listirbg/rc_car/Controller/PCB/PCB_PCB_Controller-RC-Car_2024-11-23.png

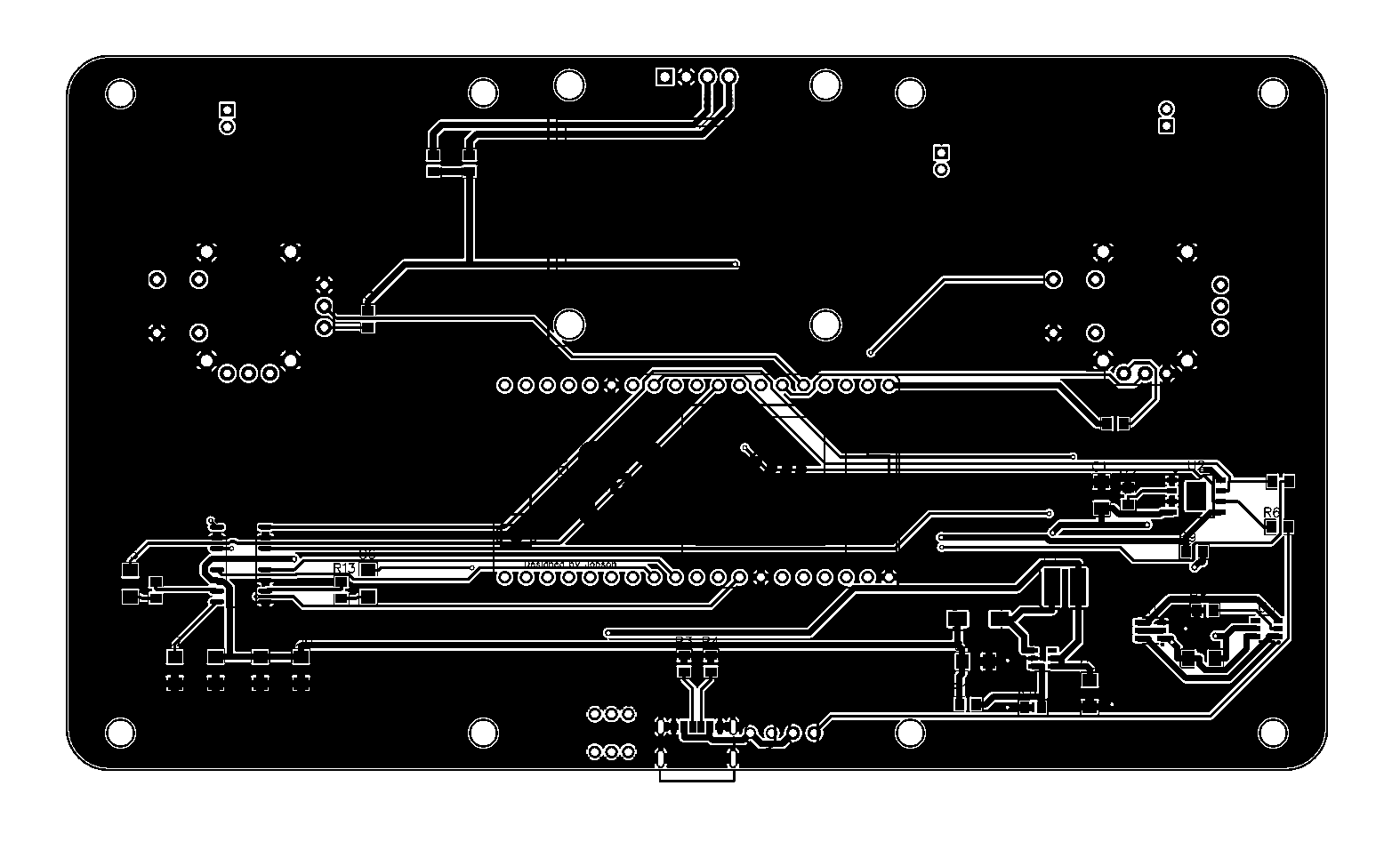
Controller/PCB/PCB_PCB_Controller-RC-Car_2024-11-23.png
