listirbg/rc_car/Kosten.xlsx

Bezeichnung | Menge | Preis | benötigt | Kosten | Kostenträger
ESP32 | 3 | 17.99 € | 2 | 11.99 € | Marcel List
Vorderachse | 1 | 25.39 € | 1 | 25.39 € | Timo Weber
Hinterachse | 1 | 20.19 € | 1 | 20.19 € | Timo Weber
Räder Set | 1 | 14.39 € | 1 | 14.39 € | Marcel List
Servomotor | 1 | 9.99 € | 1 | 9.99 € | Marcel List
Joystick | 4 | 9.99 € | 2 | 5.00 € | Marcel List
Akku Lipo 600mAh | 3 | 22.99 € | 1 | 7.66 € | Marcel List
OLED Displays 1,3" | 3 | 17.09 € | 1 | 5.70 € | Marcel List
Akku Lipo 2200mAh mit Ladegerät | 1 | 26.99 € | 1 | 26.99 € | Marcel List
Motor (mit ESC) | 1 | 31.28 € | 1 | 31.28 € | Marcel List
Lautsprecher | 4 | 8.09 € | 1 | 2.02 € | Marcel List
Platine Controller | 5 | 11.44 € | 1 | 2.29 € | Marcel List
Bauteile Controller | 5 | 22.36 € | 1 | 4.47 € | Marcel List
3D-Druck Filament pauschal | 1 | 20.00 € | 1 | 20.00 € | Marcel List
sonstige Verbrauchsmaterialien pauschal | 1 | 5.00 € | 1 | 5.00 € | alle
Gesamtkosten |  | 263.18 € |  | 192.36 €
