listirbg/rc_car/Auto/Bodenplatte v1.dxf

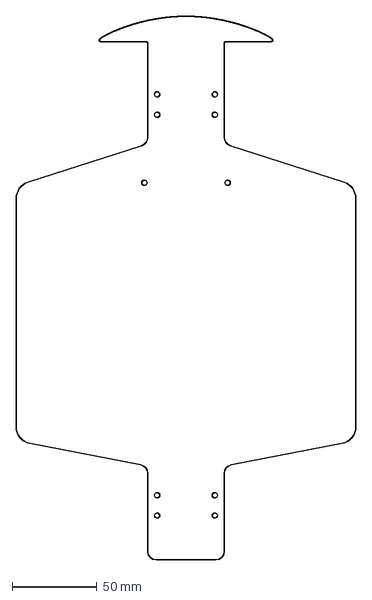
[picture p2: CAD file, 2024-12-01]
Auto/Bodenplatte v1.dxf
200.0 x 320.0 mm
