listirbg/rc_car/Controller/PCB/PCB_Controller-RC-Car_2024-11-23.dxf

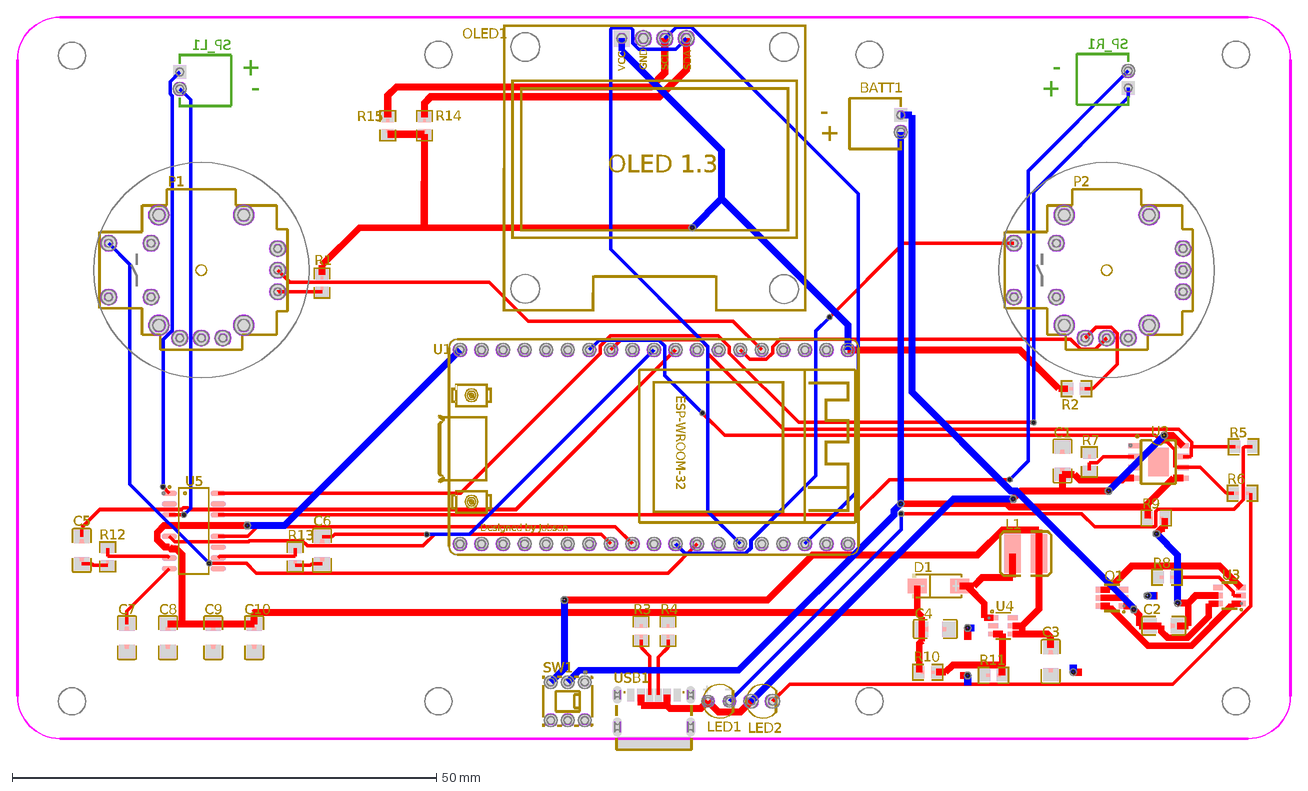
[picture p3: CAD file, 2024-12-01]
Controller/PCB/PCB_Controller-RC-Car_2024-11-23.dxf
+
-
SP_L1
SP_R1
R14
R15
C1
C2
C3
C4
D1
L1
LED1
LED2
P1
P2
Q1
U3
R1
R2
R3
R4
R5
R6
R7
R8
R9
R10
R11
SW1
U2
U4
USB1
BATT1
U1
ESP-WROOM-32
Designed by Jobson
OLED1
OLED 1.3
VCC
SCL
SDA
GND
C5
C6
C7
C8
C9
C10
R12
R13
U5
