listirbg/rc_car/(list of files, cad)

Other CAD files:
Auto/3D_Modelle/Abdeckung Welle v2.f3d
Auto/3D_Modelle/Bodenplatte v3.f3d
Auto/3D_Modelle/Halterung Akku v5.f3d
Auto/3D_Modelle/Halterung Platine v2.f3d
Auto/3D_Modelle/Halterung Servo-Motor v6.f3d
Auto/3D_Modelle/Heckspoiler v3.f3d
Auto/3D_Modelle/Lenkachse v1.f3d
Controller/3D_Modelle/Abdeckung LED v1.f3d
Controller/3D_Modelle/Button v8.f3d
Controller/3D_Modelle/Joystick v9.f3d
Controller/3D_Modelle/Joystickaufsatz v4.f3d
