listirbg/rc_car/Controller/Schaltplan/Schaltplan_Controller_RC-Car.pdf

# OLED1 SDA

## OLED

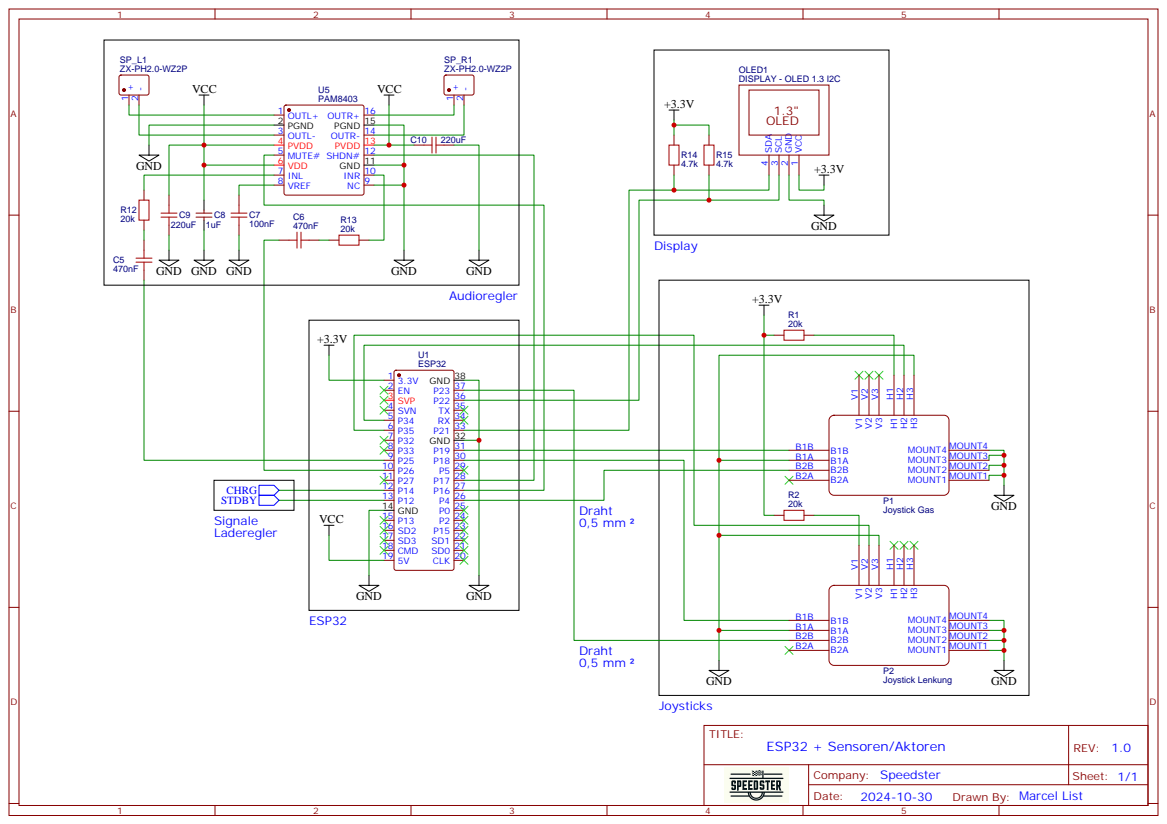
[picture p4: page 1]

PAM8403
INR 10 GND 11 SHDN# 12 PVDD 13 OUTR- 14 PGND 15 OUTR+ 16

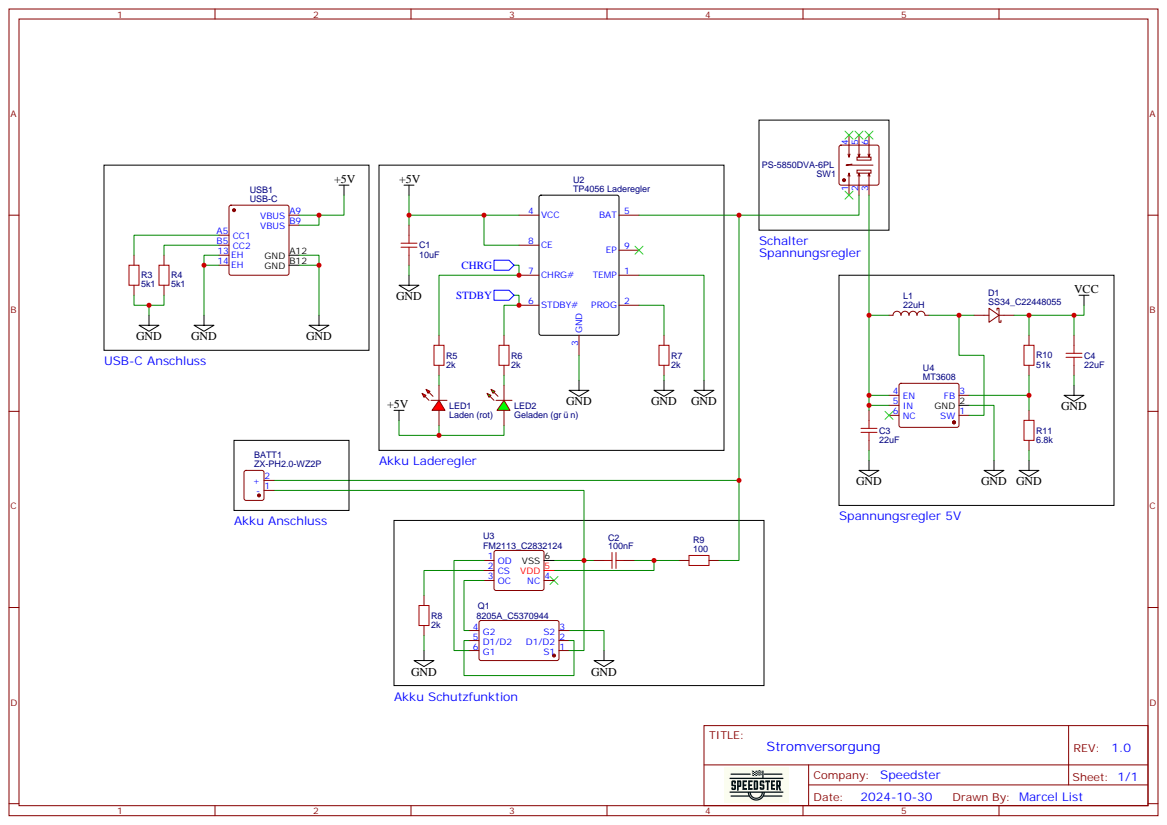
[picture p5: page 2]
