listirbg/rc_car/Auto/Schaltplan/Schaltplan_RC-Car.pdf

3S Lipo | +
12V

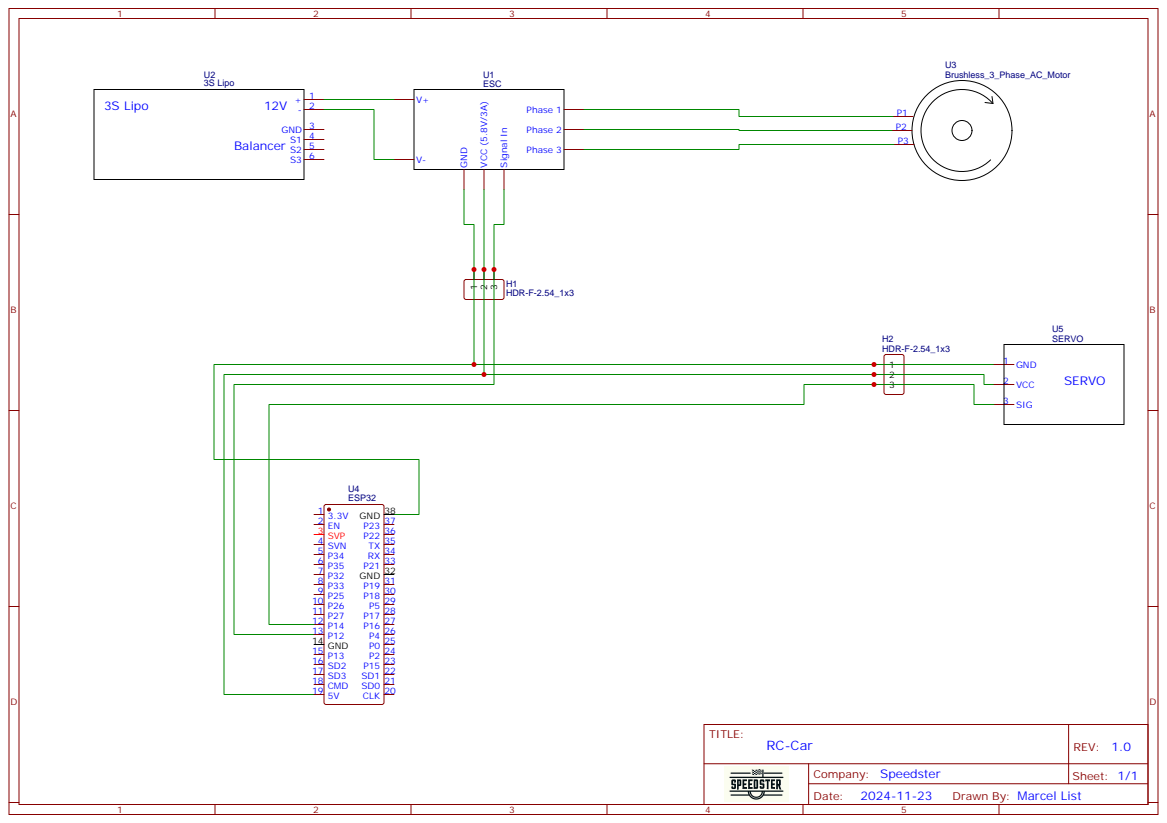
[picture p6: page 1]

Drawn By: Marcel List
