listirbg/rc_car/Software/Controller/main.py

# ######################
# Controller des RC-Cars
# ######################

# ### Modul-Imports
from machine import Pin, I2C, ADC, DAC, Timer
import sh1106
import pictures
import framebuf
import network
import espnow
import time


# ### Mac-Adressen
mac_controller = b'\x88\x13\xbfq\xc1\xcc'
mac_car = b'\xa0\xb7e-\xc4\xc4'


# ### ESP-NOW initialisieren

# WLAN aktivieren
network.phy_mode(network.MODE_11N)
sta = network.WLAN(network.STA_IF)
sta.active(True)
sta.config(pm=sta.PM_NONE)

# ESP-NOW initialisieren
en = espnow.ESPNow()
en.active(True)
en.config(timeout_ms=300)

# Empfänger hinzufügen
en.add_peer(mac_car)


# ### Funktionen definieren

# Logo auf dem Display anzeigen
def show_logo(display: sh1106.SH1106, duration_s: int = 0) -> None:
    # Logo als Byte-Array
    logo = pictures.logo()

    # FrameBuffer für das Logo erstellen
    fb = framebuf.FrameBuffer(logo, 128, 64, framebuf.MONO_VLSB)

    # Logo auf dem Display anzeigen
    display.fill(0)
    display.blit(fb, 0, 0)
    display.show()
    time.sleep(duration_s)


# Analogen Eingang einlesen, Wert stabilisieren und in 0 .. +- 100 % umwandeln
def read_input_calc(analog_input: ADC, last_val: int, hysteresis: int, invert: bool = False) -> int:
    # Wert am ADC einlesen
    val = analog_input.read_u16()
    # Wert ggf. invertieren
    if invert:
        val = -(val - 65535)
    # In Wert 0-65 umwandeln
    val = val // 1000

    # Neuen Wert in +- 100 % berechnen
    new_val = int(((val / 64) * 200) - 100)

    # Wert stabilisieren
    if (32 - hysteresis) < val < (32 + hysteresis):
        send_val = 0
    elif (new_val - last_val) < -hysteresis or (new_val - last_val) > hysteresis: # Berechnung passt nicht
        send_val = new_val
    else:
        send_val = last_val

    send_val = max(-100, min(100, send_val))
    return send_val


# Sound abspielen
def play_sound(output: DAC, output_mute: Pin, sound: str, sample_rate: int = 8000, chunk_size: int = 2048) -> None:
    output_mute.value(1)
    # Zeit zwischen Samples berechnen
    delay = int((1 / sample_rate)*1_000_000)
    with open(sound, "rb") as f:
        while True:
            chunk = f.read(chunk_size)
            if not chunk:
                break
            for sample in chunk:
                output.write(sample)
                time.sleep_us(delay)
    sound_mute.value(0)


# Auswertung Button
def button_check(button: Pin, last_state: bool) -> tuple[bool, bool]:
    state = True if not bool(button.value()) else False
    if state and state != last_state:
        return (True, state)
    else:
        return (False, state)


# ### Ein-/Ausgänge definieren

# Display SH1106 OLED (I2C)
i2c = I2C(0, scl=Pin(22), sda=Pin(21), freq=100000)
oled = sh1106.SH1106_I2C(128, 64, i2c, rotate=180)

# Steuerung
# Joystick Gas
joystick_throttle = ADC(34)
joystick_throttle_button = Pin(4, Pin.IN, Pin.PULL_UP)
joystick_angle = ADC(35)
joystick_angle_button = Pin(23, Pin.IN, Pin.PULL_UP)

# Audio-Verstärker
# sound_left_channel = DAC(25)  # nicht verwendet, da kein Lautsprecher angeschlossen
sound_right_channel = DAC(26)
sound_mute = Pin(16, Pin.OUT)
sound_shutdown = Pin(17, Pin.OUT, value=1)

# Laderegler
# charger_charging = Pin(14, Pin.IN, Pin.PULL_UP)  # Keine Verwendung
# charger_standby = Pin(12, Pin.IN, Pin.PULL_UP)  # Keine Verwendung


# ### Programmablauf

# Logo im Display anzeigen
show_logo(oled, 0)

# Sound abspielen
play_sound(sound_right_channel, sound_mute, "startup.raw")

# Null-Werte definieren
joystick_angle_button_flank = (False, False)
joystick_throttle_button_flank = (False, False)
speed_mode = 0
send_val_throttle = 32
send_val_angle = 32
connection = False
timer_connection = 0
first_cycle = True

# Geschwindigkeitsmodi
speed_modes = [0.1, 0.25, 0.5, 0.75, 1]


# ### Main-Loop
while True:
    try:
        # Buttons auswerten
        joystick_angle_button_flank = button_check(joystick_angle_button, joystick_angle_button_flank[1])
        joystick_throttle_button_flank = button_check(joystick_throttle_button, joystick_throttle_button_flank[1])

        # Fahrmodi umschalten
        if joystick_angle_button_flank[0] and speed_mode < len(speed_modes) - 1:
            speed_mode += 1
        elif joystick_angle_button_flank[0] and speed_mode == len(speed_modes) - 1:
            speed_mode = 0

        max_throttle = speed_modes[speed_mode]

        # Werte einlesen
        val_throttle = read_input_calc(joystick_throttle, send_val_throttle, 3, True)
        send_val_throttle = int(val_throttle * max_throttle)
        if 0 < send_val_throttle < 5:
            send_val_throttle = 5
        elif -5 < send_val_throttle < 0:
            send_val_throttle = -5

        send_val_angle = read_input_calc(joystick_angle, send_val_angle, 3, False)

        # Werte an RC-Car senden
        send_text = f"gas:{int(send_val_throttle)},angle:{send_val_angle}"
        send_response = en.send(mac_car, str(send_text), True)
        if not send_response:
            raise Exception("Error sending data")

        # Signalstärke überwachen
        en.recv()
        peers_table = en.peers_table
        if not timer_connection:
            timer_connection = time.time()
        timer_expired = True if (timer_connection >= 2) else False
        if mac_car in peers_table:
            peer_signal_strength = -(peers_table[mac_car][0])
            if timer_expired or first_cycle:
                if 0 <= peer_signal_strength <= 80:
                    pic_signal = pictures.connection_3_16x16()
                elif 81 <= peer_signal_strength <= 90:
                    pic_signal = pictures.connection_2_16x16()
                else:
                    pic_signal = pictures.connection_1_16x16()
            connection = True
            timer_connection = 0
            first_cycle = False
        else:
            pic_signal = pictures.connection_0_16x16()
    # Bei fehlgeschlagener Verbindung
    except Exception as e:
        connection = False
        pic_signal = pictures.connection_0_16x16()
    finally:
        # Anzeige Display
        oled.fill(0)

        # Bei vorhandener Verbindung
        if connection:
            # Fahrmodus max. Geschwindigkeit
            fb_tacho_max = framebuf.FrameBuffer(pictures.tacho_max_20x20(), 20, 20, framebuf.MONO_VLSB)
            oled.blit(fb_tacho_max, 0, 0)
            oled.text(f"{100*max_throttle:3} %", 22, 5, 1)

            # Aktuelle Geschwindigkeit
            fb_tacho = framebuf.FrameBuffer(pictures.tacho_30x30(), 30, 30, framebuf.MONO_VLSB)
            oled.blit(fb_tacho, 30, 28)
            oled.text(f"{val_throttle:4} %", 64, 40, 1)
        # Bei keiner Verbindung
        else:
            # Text Verbinde...
            oled.text("Verbinde...", 24, 30, 1)

        # Verbindung
        fb_connection = framebuf.FrameBuffer(pic_signal, 16, 16, framebuf.MONO_VLSB)
        oled.blit(fb_connection, 111, 1)

        oled.show()
