listirbg/rc_car/(commit log)

2024-12-01 Woche 6 (KW48: 25.11. - 01.12.2024)
    [Bodenplatte v1.dxf, Kosten.xlsx]
2024-12-08 Woche 7 (KW49: 02.12. - 08.12.2024)
    [Bodenplatte v3.f3d, Halterung Akku v5.f3d, Halterung Gewindeeinsatz v1.f3d, Halterung Platine v2.f3d, Halterung Servo-Motor v6.f3d, Halterung_Display v1.3mf, Joystick v7.f3d]
2024-12-22 Woche 9 (KW51: 16.12. - 22.12.2024)
    [Bodenplatte v3.f3d, Halterung Akku v5.f3d, Halterung Gewindeeinsatz v1.f3d, Halterung Platine v2.f3d, Halterung Servo-Motor v6.f3d, Halterung_Display v1.3mf, Joystick v7.f3d, Kosten.xlsx]
2024-12-30 Woche 10 (KW52: 23.12. - 29.12.2024)
    [Abdeckung LED v1.f3d, Abdeckung Welle v2.f3d, Button v8.f3d, Heckspoiler v3.f3d, Joystick v9.f3d, Joystickaufsatz v4.f3d, Lenkachse v1.f3d]
